gbThreepwood/headphone-amp/power-supply/img/enclosure_drawing.png

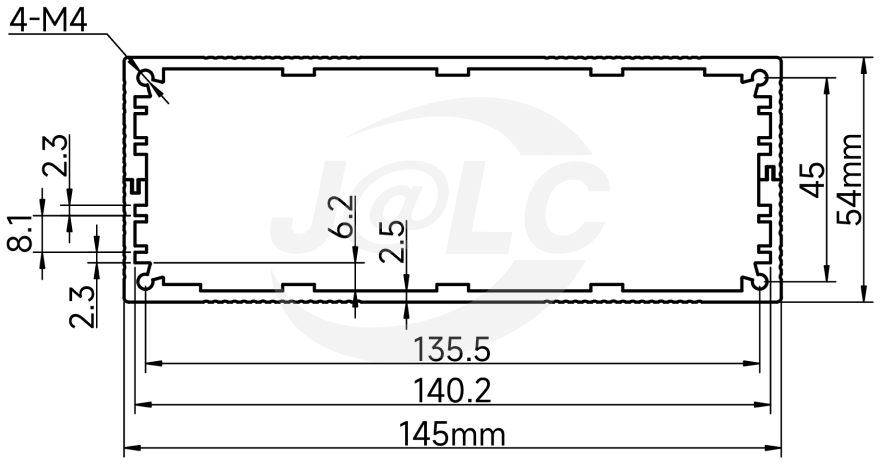
power-supply/img/enclosure_drawing.png
