gbThreepwood/headphone-amp/power-supply/3d_models/toroidal_transformer-Assembly.step

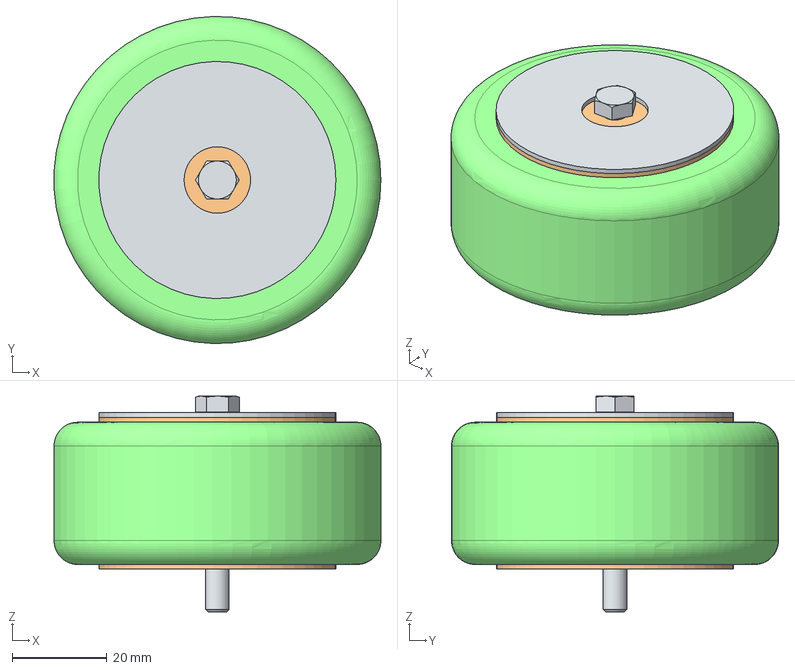
[picture p3: CAD file, 2025-01-01]
power-supply/3d_models/toroidal_transformer-Assembly.step
68.9 x 69.0 x 45.5 mm
Core001
Gasket x 2
Washer
M5x42-Screw
