gbThreepwood/headphone-amp/headphone-amp/3d_models/SJ-63073E.step

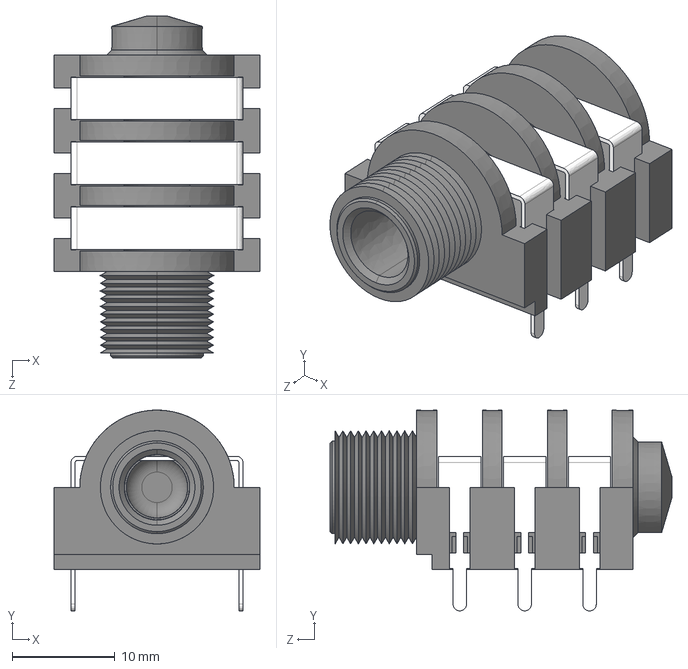
[picture p4: CAD file, 2025-01-01]
headphone-amp/3d_models/SJ-63073E.step
20.0 x 19.5 x 33.2 mm
