gbThreepwood/headphone-amp/enclosure/power-supply/aluminium_enclosure.FCStd

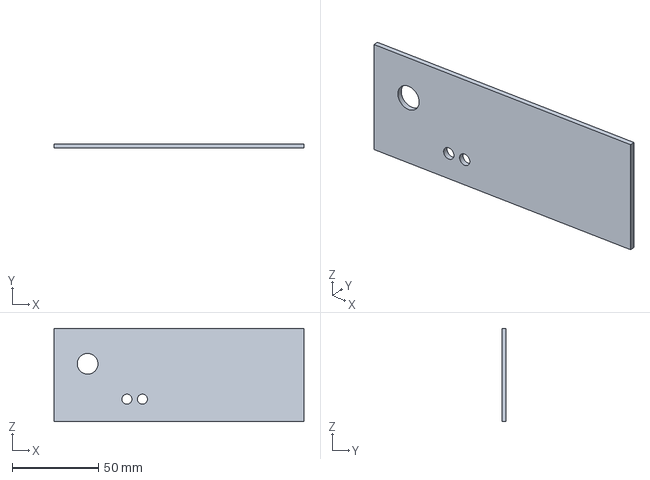
[picture p5: CAD file, 2024-12-26]
enclosure/power-supply/aluminium_enclosure.FCStd
145.0 x 2.50 x 54.0 mm
