gbThreepwood/headphone-amp/headphone-amp/3d_models/Same_Sky_RCJ-2211.step

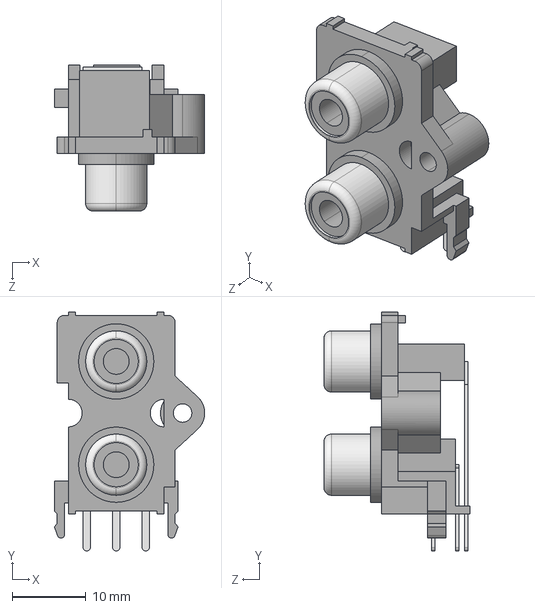
[picture p7: CAD file, 2025-01-01]
headphone-amp/3d_models/Same_Sky_RCJ-2211.step
20.4 x 32.4 x 19.8 mm
RCJ-22_RCJ-22XX
PLUG_Black x 2
