gbThreepwood/headphone-amp/headphone-amp/3d_models/PD-30.step

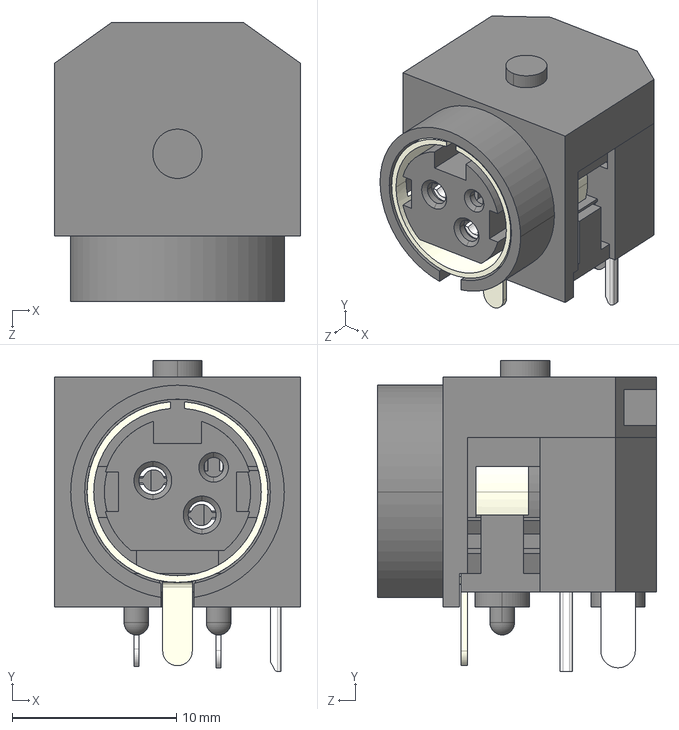
[picture p8: CAD file, 2025-01-01]
headphone-amp/3d_models/PD-30.step
15.0 x 18.9 x 17.0 mm
