gbThreepwood/headphone-amp/(list of files, cad)

Other CAD files:
enclosure/power-supply/pcb_enclosure_assembly.FCStd
