gbThreepwood/headphone-amp/headphone-amp/ltspice/toggle_circuit.asc

C1: cap; 470n
D1: diode; 1N4148
M1: nmos; BSP89
M2: pmos; BSS84
R1: res; 10k
R2: res; 100k
R3: res; 300
R4: res; 100k
S1: sw; MYSW
V1: voltage; 12
V2: voltage; PULSE(0 1 1 1n 1n 1 2)
Named nets: 0
.tran 7 startup
.model MYSW SW(Ron=1 Roff=1Meg Vt=.5 Vh=-.4)
