gbThreepwood/headphone-amp/power-supply/power-supply.kicad_pcb

## KiCad design power-supply/power-supply.kicad_pcb (2025-01-01)

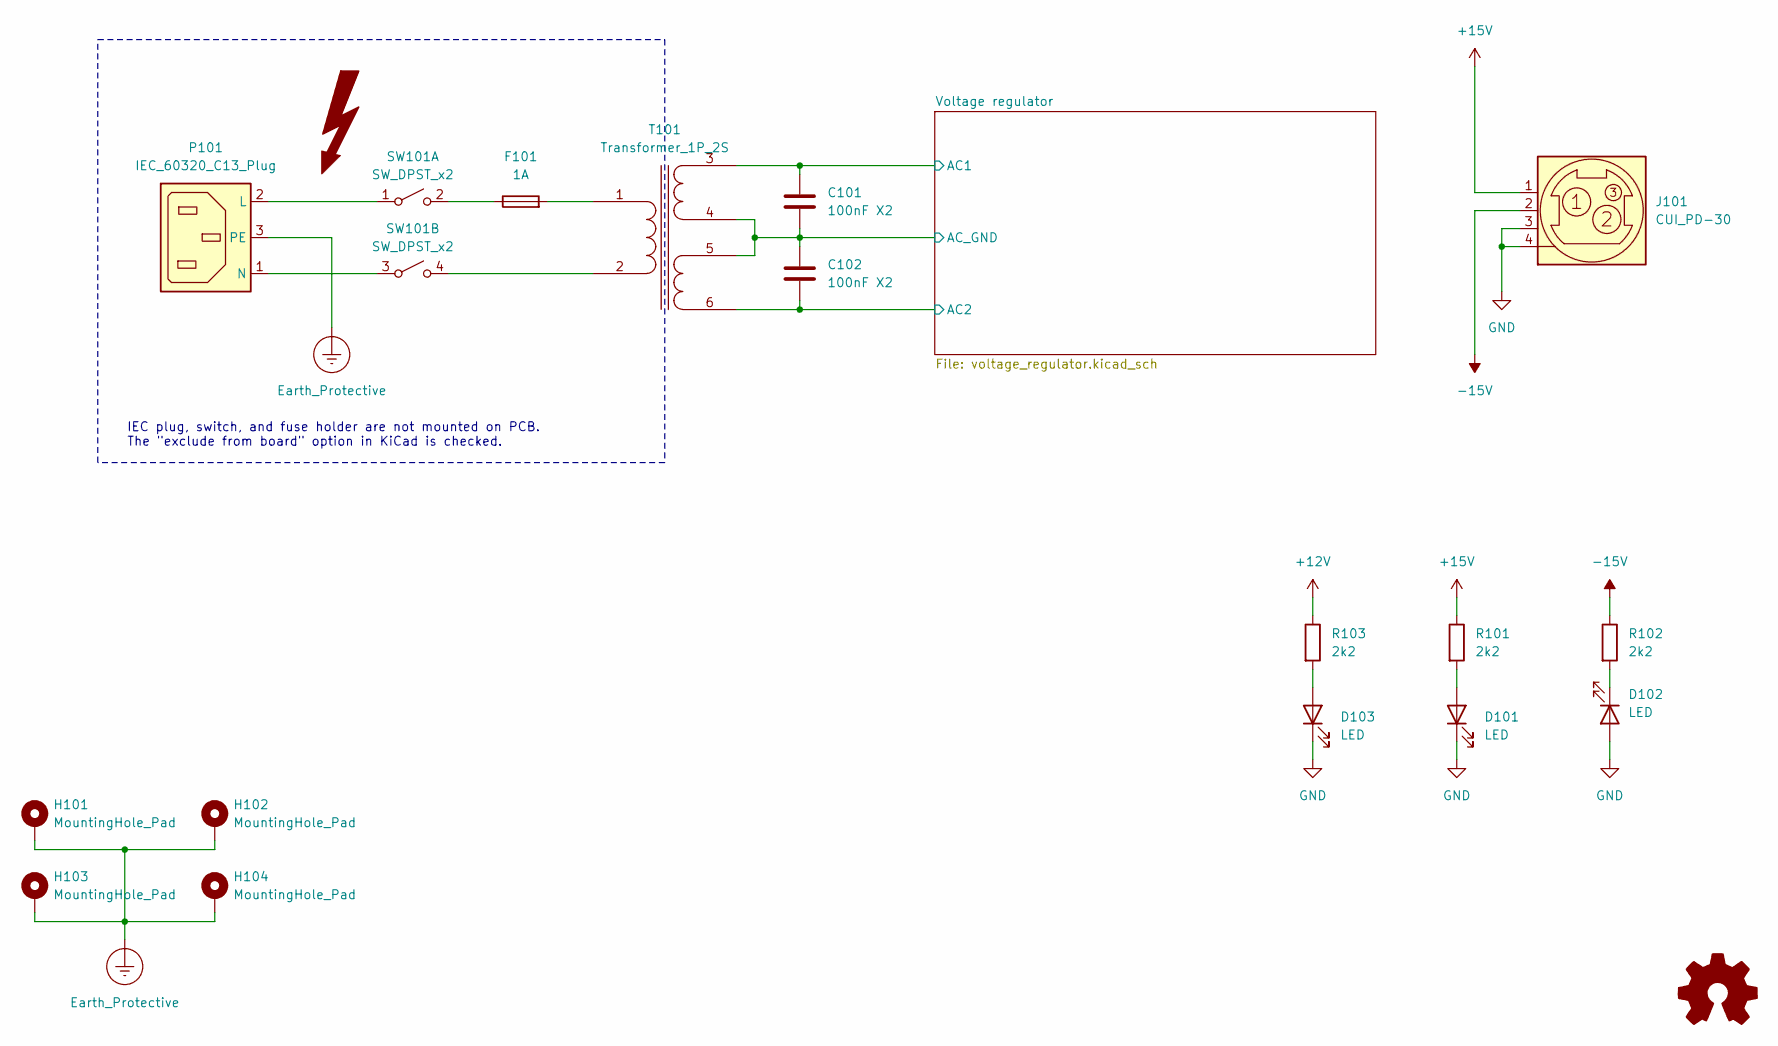
[picture p9: schematic power-supply.kicad_sch, Linear power supply]

Parts:
C101, C102: 100nF X2; C_Axial_L19.0mm_D7.5mm_P25.00mm_Horizontal
D101, D102, D103: LED; LED_D5.0mm_Horizontal_O3.81mm_Z3.0mm
F101: 1A
H101, H102, H103, H104: MountingHole_Pad; MountingHole_4mm_Pad_TopBottom
J101: CUI_PD-30
P101: IEC_60320_C13_Plug
R101, R102, R103: 2k2; R_Axial_DIN0207_L6.3mm_D2.5mm_P10.16mm_Horizontal
SW101: SW_DPST_x2
T101: Transformer_1P_2S; ToroidalTransformer 30VA

Connections:
+12V: R103.1; also elsewhere on the board
+15V: J101.1, R101.1; also elsewhere on the board
-15V: J101.2, R102.1; also elsewhere on the board
/Voltage regulator/AC1: C101.1, T101.3 (SA); also elsewhere on the board
/Voltage regulator/AC2: C102.2, T101.6 (SD); also elsewhere on the board
Earth_Protective: H101.1, H102.1, H103.1, H104.1, P101.3 (PE)
GND: C101.2, C102.1, D101.1 (K), D102.2 (A), D103.1 (K), J101.3, J101.4 (Shield), T101.4 (SB), T101.5 (SC); also elsewhere on the board
unnamed: D101.2 (A), R101.2
unnamed: D102.1 (K), R102.2
unnamed: D103.2 (A), R103.2
unnamed: F101.1, SW101.2 (B)
unnamed: P101.1 (N), SW101.3 (A)
unnamed: P101.2 (L), SW101.1 (A)
unnamed: F101.2, T101.1 (AA)
unnamed: SW101.4 (B), T101.2 (AB)

Notes on the sheet:
IEC plug, switch, and fuse holder are not mounted on PCB. The "exclude from board" option in KiCad is checked.

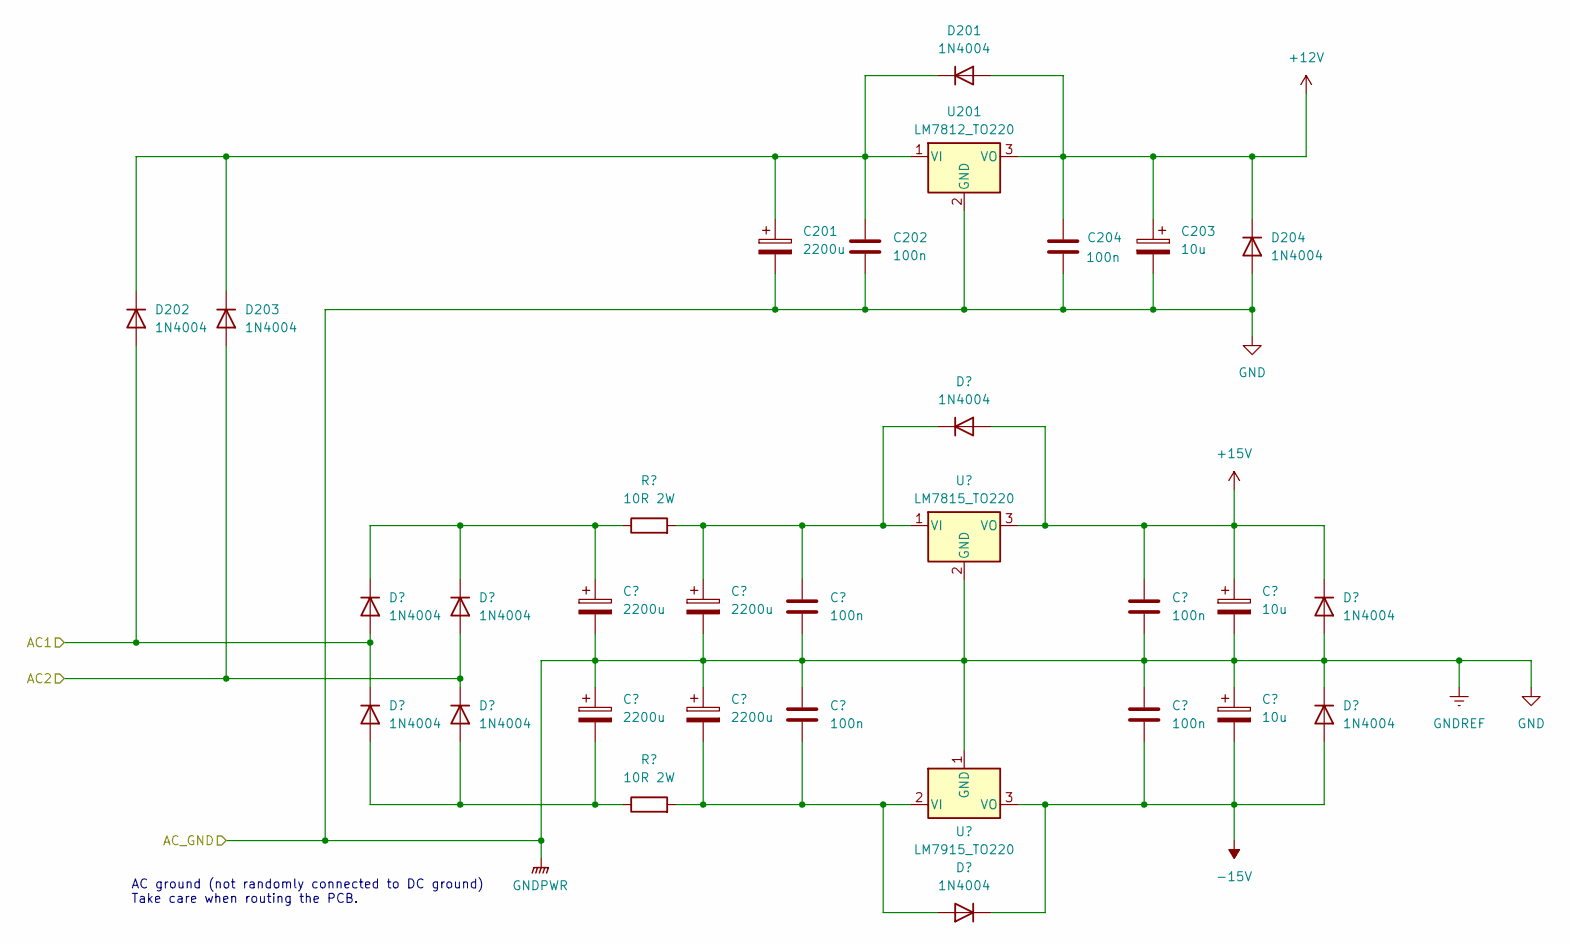
[picture p10: schematic voltage_regulator.kicad_sch, Dual voltage power supply]

Parts:
C201, C401, C402, C403, C404: 2200u; CP_Radial_D18.0mm_P7.50mm
C202, C204, C405, C406, C407, C408: 100n; C_Disc_D6.0mm_W2.5mm_P5.00mm
C203, C409, C410: 10u; CP_Radial_D5.0mm_P2.00mm
D201, D202, D203, D204, D401, D402, D403, D404, D405, D406, D408, D409: 1N4004; D_DO-41_SOD81_P10.16mm_Horizontal
R401, R402: 10R 2W; R_Axial_DIN0309_L9.0mm_D3.2mm_P12.70mm_Horizontal
U201: LM7812_TO220; TO-220-3_Vertical
U401: LM7815_TO220; TO-220-3_Vertical
U402: LM7915_TO220; TO-220-3_Vertical

Connections:
+12V: C203.1, C204.1, D201.2 (A), D204.1 (K), U201.3 (VO); also elsewhere on the board
+15V: C407.1, C409.1, D405.2 (A), D408.1 (K), U401.3 (VO); also elsewhere on the board
-15V: C408.2, C410.2, D406.1 (K), D409.2 (A), U402.3 (VO); also elsewhere on the board
/Voltage regulator/AC1: D202.2 (A), D401.2 (A), D402.1 (K); also elsewhere on the board
/Voltage regulator/AC2: D203.2 (A), D403.2 (A), D404.1 (K); also elsewhere on the board
GND: C201.2, C202.2, C203.2, C204.2, C401.2, C402.1, C403.2, C404.1, C405.2, C406.1, C407.2, C408.1, C409.2, C410.1, D204.2 (A), D408.2 (A), D409.1 (K), U201.2 (GND), U401.2 (GND), U402.1 (GND); also elsewhere on the board
unnamed: C201.1, C202.1, D201.1 (K), D202.1 (K), D203.1 (K), U201.1 (VI)
unnamed: C401.1, D401.1 (K), D403.1 (K), R401.1
unnamed: C402.2, D402.2 (A), D404.2 (A), R402.1
unnamed: C403.1, C405.1, D405.1 (K), R401.2, U401.1 (VI)
unnamed: C404.2, C406.2, D406.2 (A), R402.2, U402.2 (VI)

Notes on the sheet:
AC ground (not randomly connected to DC ground) Take care when routing the PCB.

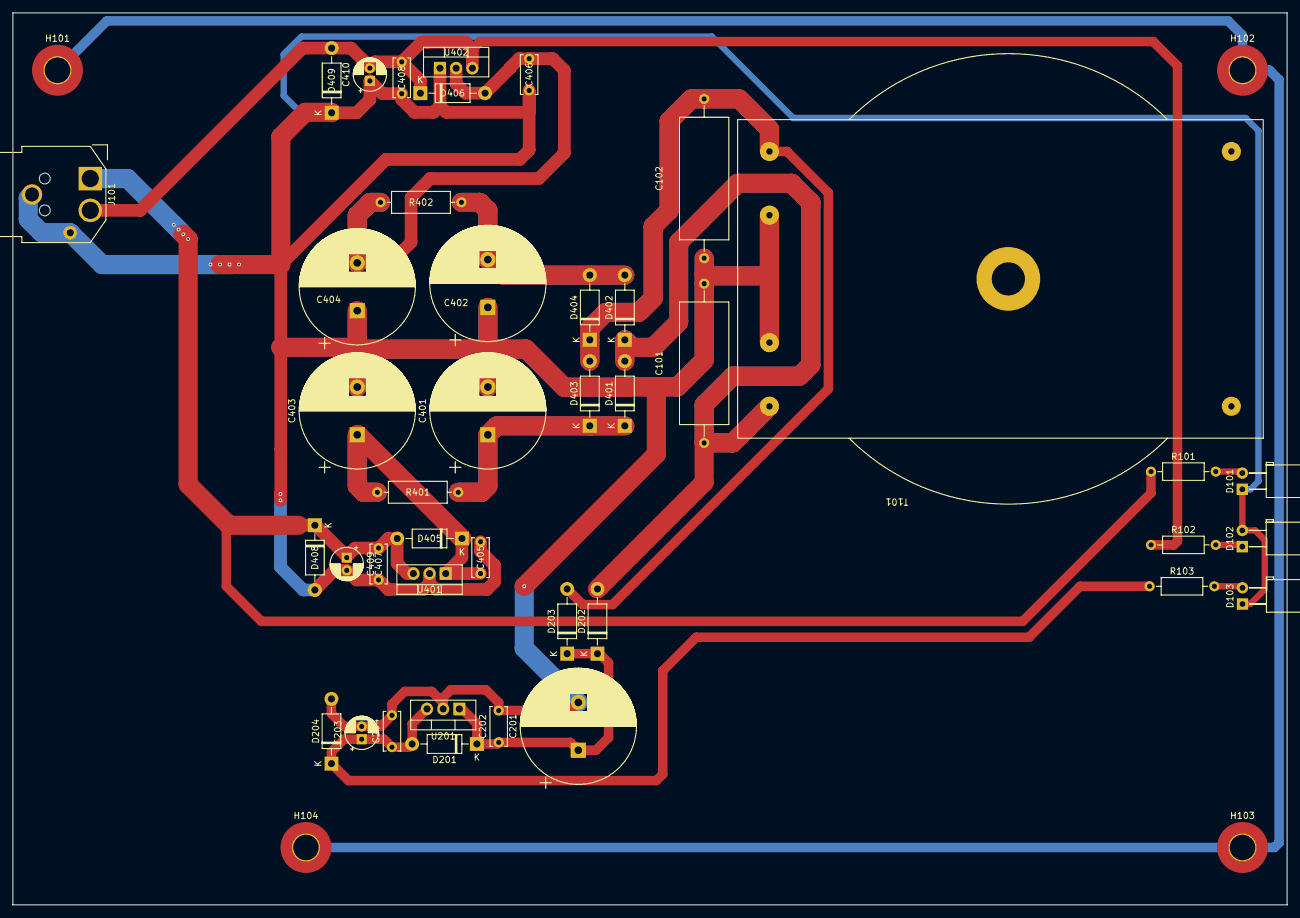
[picture p11: board power-supply.kicad_pcb from above]

Board: 2 copper layers, 200.0 x 140.0 mm, 45 parts (0 on the bottom side), 15 nets.
