gbThreepwood/headphone-amp/headphone-amp/headphone-amp.kicad_pcb

## KiCad design headphone-amp/headphone-amp.kicad_pcb (2025-01-01)

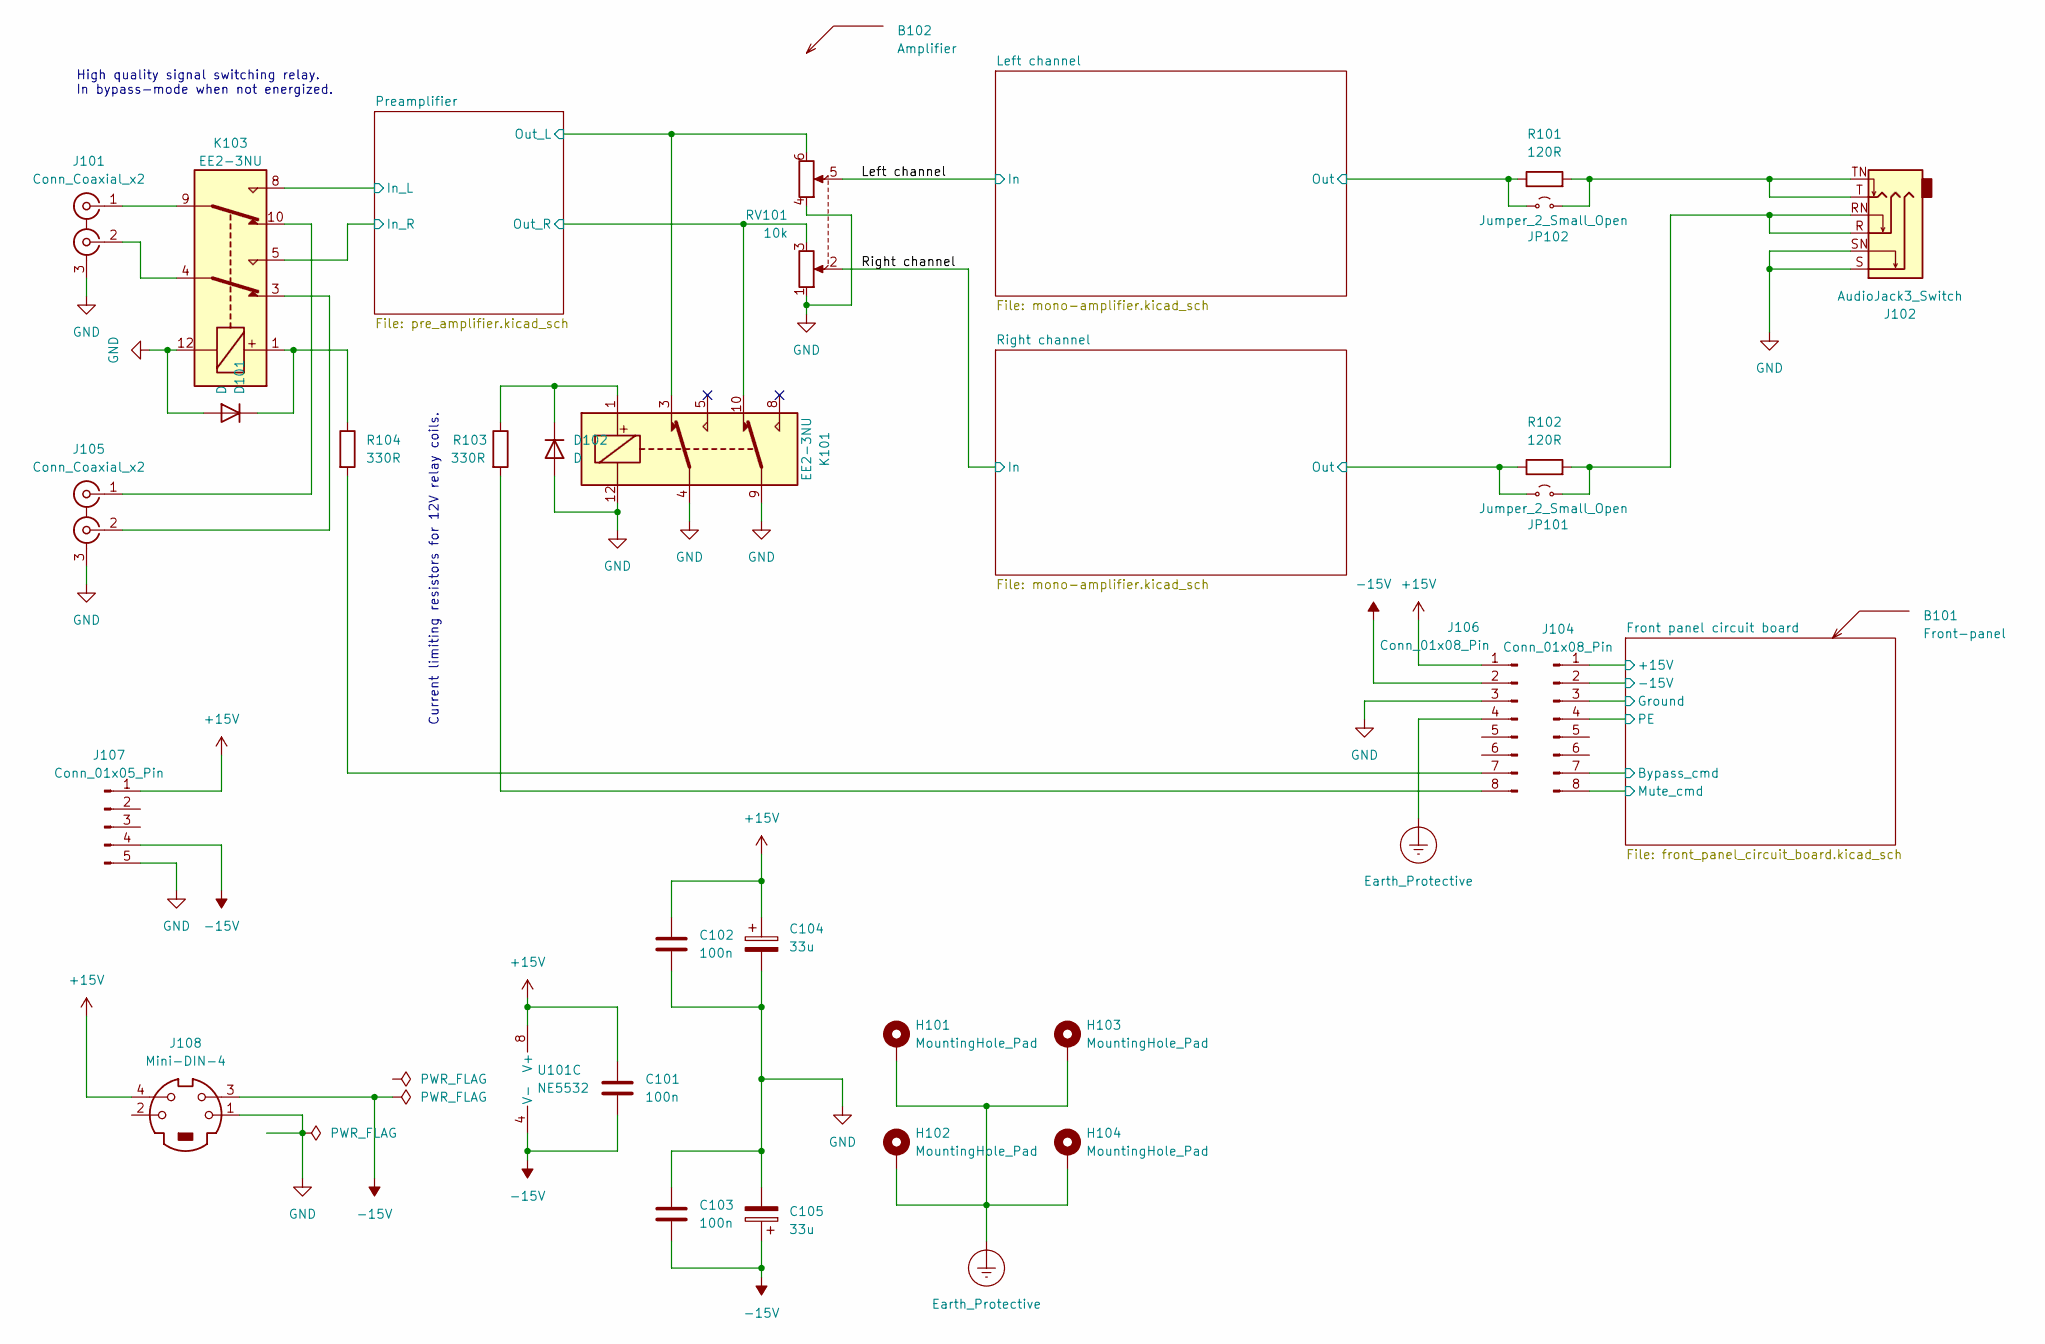
[picture p12: schematic headphone-amp.kicad_sch, HiFi headphone amplifier]

Parts:
B101: Front-panel; Board
B102: Amplifier; Board
C101, C102, C103: 100n; C_Disc_D6.0mm_W2.5mm_P5.00mm
C104, C105: 33u; CP_Radial_D6.3mm_P2.50mm
D101, D102: D; D_DO-35_SOD27_P7.62mm_Horizontal
H101, H102, H103, H104: MountingHole_Pad; MountingHole_4.3mm_M4_DIN965_Pad_TopBottom
J101, J105: Conn_Coaxial_x2; rcj-22 vertical RCA
J102: AudioJack3_Switch; CUI_SJ-63073E
J104, J106: Conn_01x08_Pin; PinHeader_1x08_P2.54mm_Vertical
J107: Conn_01x05_Pin; PhoenixContact_GMSTB_2,5_5-GF-7,62_1x05_P7.62mm_Horizontal_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
J108: Mini-DIN-4
JP101, JP102: Jumper_2_Small_Open; PinHeader_2x01_P2.54mm_Vertical
K101, K103: EE2-3NU; Relay_DPDT_Kemet_EE2_NU
R101, R102: 120R; R_Axial_DIN0207_L6.3mm_D2.5mm_P10.16mm_Horizontal
R103, R104: 330R; R_Axial_DIN0207_L6.3mm_D2.5mm_P10.16mm_Horizontal
RV101: 10k; Potentiometer_Alps_RK163_Dual_Horizontal
U101: NE5532; DIP-8_W7.62mm_LongPads

Connections:
+15V: C101.1, C102.1, C104.1, J106.1, J107.1, J108.4, U101.8 (V+); also elsewhere on the board
-15V: C101.2, C103.1, C105.1, J106.2, J107.4, J108.3, U101.4 (V-); also elsewhere on the board
/Front panel circuit board/+15V: J104.1; also elsewhere on the board
/Front panel circuit board/-15V: J104.2
/Front panel circuit board/Bypass_cmd: J104.7; also elsewhere on the board
/Front panel circuit board/Ground: J104.3; also elsewhere on the board
/Front panel circuit board/Mute_cmd: J104.8; also elsewhere on the board
/Front panel circuit board/PE: J104.4; also elsewhere on the board
/Left channel: RV101.5; also elsewhere on the board
/Left channel/Out: JP102.1 (A), R101.1; also elsewhere on the board
/Preamplifier/In_L: K103.8; also elsewhere on the board
/Preamplifier/In_R: K103.5; also elsewhere on the board
/Preamplifier/Out_L: K101.3, RV101.6; also elsewhere on the board
/Preamplifier/Out_R: K101.10, RV101.3; also elsewhere on the board
/Right channel: RV101.2; also elsewhere on the board
/Right channel/Out: JP101.1 (A), R102.1; also elsewhere on the board
Earth_Protective: H101.1, H102.1, H103.1, H104.1, J106.4
GND: C102.2, C103.2, C104.2, C105.2, D101.2 (A), D102.2 (A), J101.3 (EXT), J102.S, J102.SN, J105.3 (EXT), J106.3, J107.5, J108.1, K101.4, K101.9, K101.12, K103.12, RV101.1, RV101.4; also elsewhere on the board
unnamed: D101.1 (K), K103.1, R104.1
unnamed: D102.1 (K), K101.1, R103.1
unnamed 31: U101.1; also elsewhere on the board
unnamed: J101.1 (IN1), K103.9
unnamed: J101.2 (IN2), K103.4
unnamed: J105.1 (IN1), K103.10
unnamed: J105.2 (IN2), K103.3
unnamed: J106.7, R104.2
unnamed: J106.8, R103.2
unnamed: J102.R, J102.RN, JP101.2 (B), R102.2
unnamed: J102.T, J102.TN, JP102.2 (B), R101.2
unnamed 55: U101.3 (+); also elsewhere on the board
unnamed 56: U101.2 (-); also elsewhere on the board

Notes on the sheet:
Current limiting resistors for 12V relay coils.
High quality signal switching relay. In bypass-mode when not energized.

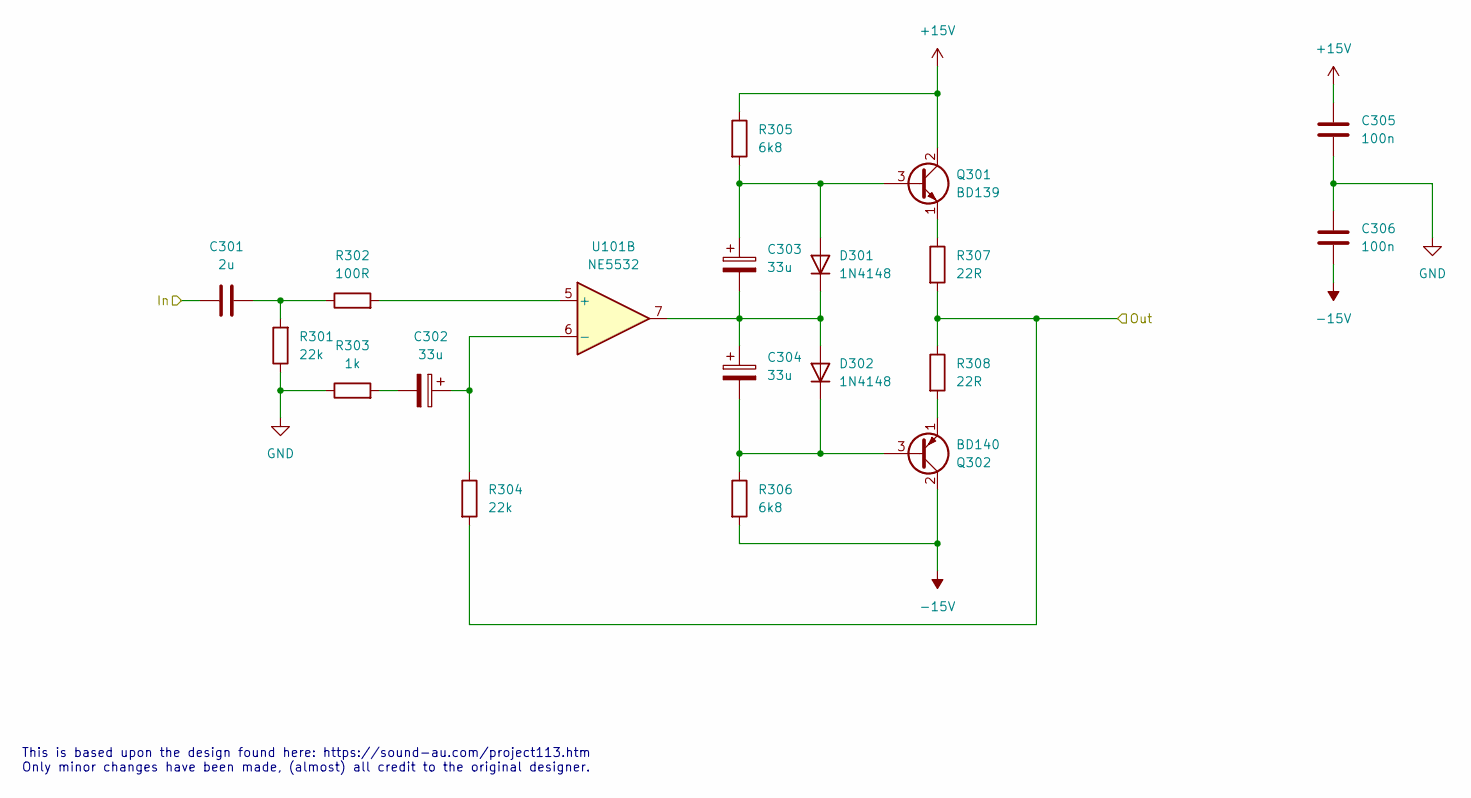
[picture p13: schematic mono-amplifier.kicad_sch, One channel of headphone amplifier]

Parts:
C301: 2u; C_Axial_L12.0mm_D7.5mm_P15.00mm_Horizontal
C302, C303, C304: 33u; CP_Radial_D6.3mm_P2.50mm
C305, C306: 100n; C_Disc_D6.0mm_W2.5mm_P5.00mm
D301, D302: 1N4148; D_DO-35_SOD27_P7.62mm_Horizontal
Q301: BD139; TO-126-3_Vertical
Q302: BD140; TO-126-3_Vertical
R301, R304: 22k; R_Axial_DIN0207_L6.3mm_D2.5mm_P10.16mm_Horizontal
R302: 100R; R_Axial_DIN0207_L6.3mm_D2.5mm_P10.16mm_Horizontal
R303: 1k; R_Axial_DIN0207_L6.3mm_D2.5mm_P10.16mm_Horizontal
R305, R306: 6k8; R_Axial_DIN0207_L6.3mm_D2.5mm_P10.16mm_Horizontal
R307, R308: 22R; R_Axial_DIN0207_L6.3mm_D2.5mm_P10.16mm_Horizontal
U101: NE5532; DIP-8_W7.62mm_LongPads

Connections:
+15V: C305.2, Q301.2 (C), R305.1; also elsewhere on the board
-15V: C306.1, Q302.2 (C), R306.2; also elsewhere on the board
/Right channel: C301.1; also elsewhere on the board
/Right channel/Out: R304.2, R307.2, R308.1; also elsewhere on the board
GND: C305.1, C306.2, R301.1, R303.1; also elsewhere on the board
unnamed: C301.2, R301.2, R302.1
unnamed: C302.2, R303.2
unnamed 31: U101.1; also elsewhere on the board
unnamed: C303.1, D301.2 (A), Q301.3 (B), R305.2
unnamed: C303.2, C304.1, D301.1 (K), D302.2 (A), U101.7
unnamed: C304.2, D302.1 (K), Q302.3 (B), R306.1
unnamed: Q301.1 (E), R307.1
unnamed: Q302.1 (E), R308.2
unnamed 55: U101.3 (+); also elsewhere on the board
unnamed 56: U101.2 (-); also elsewhere on the board
unnamed: R302.2, U101.5 (+)
unnamed: C302.1, R304.1, U101.6 (-)

Parts of its further copies:
C201: 2u; C_Axial_L12.0mm_D7.5mm_P15.00mm_Horizontal
C202, C203, C204: 33u; CP_Radial_D6.3mm_P2.50mm
C205, C206: 100n; C_Disc_D6.0mm_W2.5mm_P5.00mm
D201, D202: 1N4148; D_DO-35_SOD27_P7.62mm_Horizontal
Q201: BD139; TO-126-3_Vertical
Q202: BD140; TO-126-3_Vertical
R201, R204: 22k; R_Axial_DIN0207_L6.3mm_D2.5mm_P10.16mm_Horizontal
R202: 100R; R_Axial_DIN0207_L6.3mm_D2.5mm_P10.16mm_Horizontal
R203: 1k; R_Axial_DIN0207_L6.3mm_D2.5mm_P10.16mm_Horizontal
R205, R206: 6k8; R_Axial_DIN0207_L6.3mm_D2.5mm_P10.16mm_Horizontal
R207, R208: 22R; R_Axial_DIN0207_L6.3mm_D2.5mm_P10.16mm_Horizontal

Connections of its further copies:
+15V: C205.2, Q201.2 (C), R205.1; also elsewhere on the board
-15V: C206.1, Q202.2 (C), R206.2; also elsewhere on the board
/Left channel: C201.1; also elsewhere on the board
/Left channel/Out: R204.2, R207.2, R208.1; also elsewhere on the board
GND: C205.1, C206.2, R201.1, R203.1; also elsewhere on the board
unnamed: C201.2, R201.2, R202.1
unnamed: C202.2, R203.2
unnamed: C203.1, D201.2 (A), Q201.3 (B), R205.2
unnamed 31: C203.2, C204.1, D201.1 (K), D202.2 (A); also elsewhere on the board
unnamed: C204.2, D202.1 (K), Q202.3 (B), R206.1
unnamed: Q201.1 (E), R207.1
unnamed: Q202.1 (E), R208.2
unnamed 55: R202.2; also elsewhere on the board
unnamed 56: C202.1, R204.1; also elsewhere on the board

Notes on the sheet:
This is based upon the design found here: https://sound-au.com/project113.htm Only minor changes have been made, (almost) all credit to the original designer.

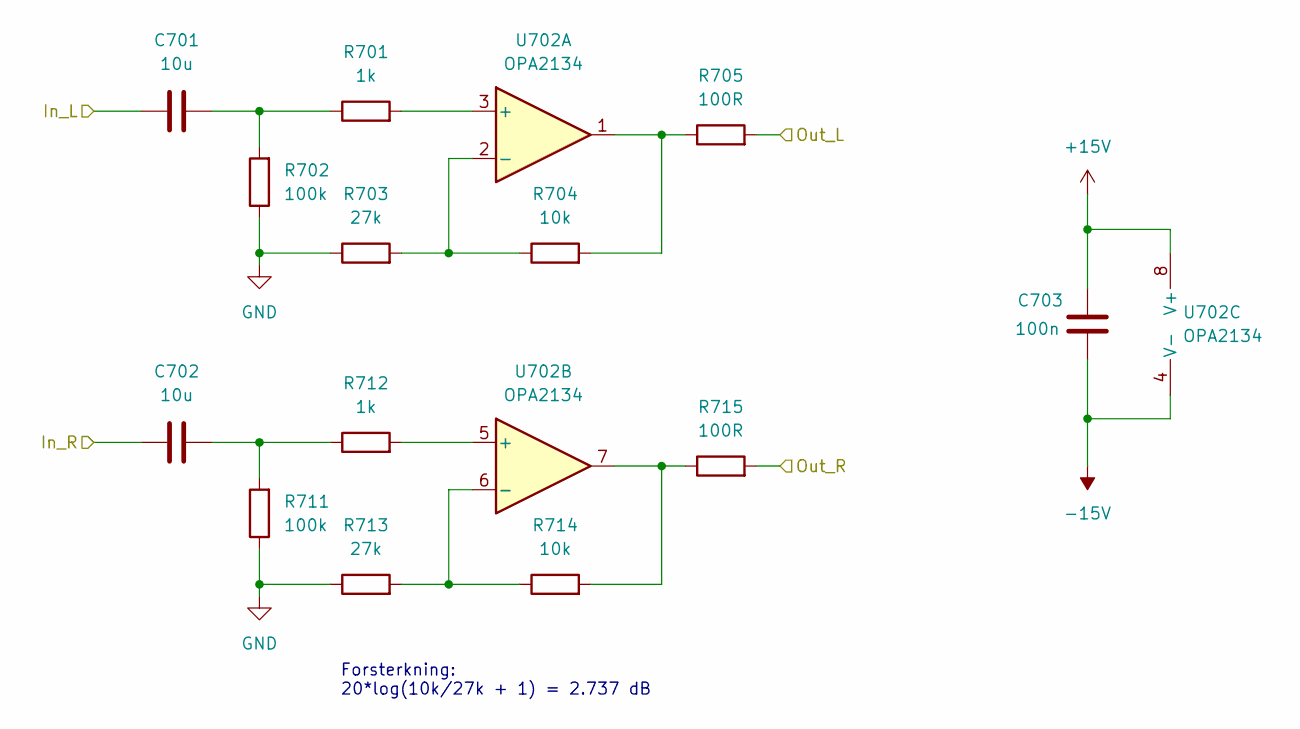
[picture p14: schematic pre_amplifier.kicad_sch]

Parts:
C701, C702: 10u; C_Axial_L12.0mm_D7.5mm_P15.00mm_Horizontal
C703: 100n; C_Disc_D6.0mm_W2.5mm_P5.00mm
R701, R712: 1k; R_Axial_DIN0207_L6.3mm_D2.5mm_P10.16mm_Horizontal
R702, R711: 100k; R_Axial_DIN0207_L6.3mm_D2.5mm_P10.16mm_Horizontal
R703, R713: 27k; R_Axial_DIN0207_L6.3mm_D2.5mm_P10.16mm_Horizontal
R704, R714: 10k; R_Axial_DIN0207_L6.3mm_D2.5mm_P10.16mm_Horizontal
R705, R715: 100R; R_Axial_DIN0207_L6.3mm_D2.5mm_P10.16mm_Horizontal
U702: OPA2134; DIP-8_W7.62mm_LongPads

Connections:
+15V: C703.1, U702.8 (V+); also elsewhere on the board
-15V: C703.2, U702.4 (V-); also elsewhere on the board
/Preamplifier/In_L: C701.1; also elsewhere on the board
/Preamplifier/In_R: C702.1; also elsewhere on the board
/Preamplifier/Out_L: R705.2; also elsewhere on the board
/Preamplifier/Out_R: R715.2; also elsewhere on the board
GND: R702.1, R703.1, R711.1, R713.1; also elsewhere on the board
unnamed: C701.2, R701.1, R702.2
unnamed: C702.2, R711.2, R712.1
unnamed: R704.2, R705.1, U702.1
unnamed: R714.2, R715.1, U702.7
unnamed: R701.2, U702.3 (+)
unnamed: R703.2, R704.1, U702.2 (-)
unnamed: R712.2, U702.5 (+)
unnamed: R713.2, R714.1, U702.6 (-)

Notes on the sheet:
Forsterkning: 20*log(10k/27k + 1) = 2.737 dB

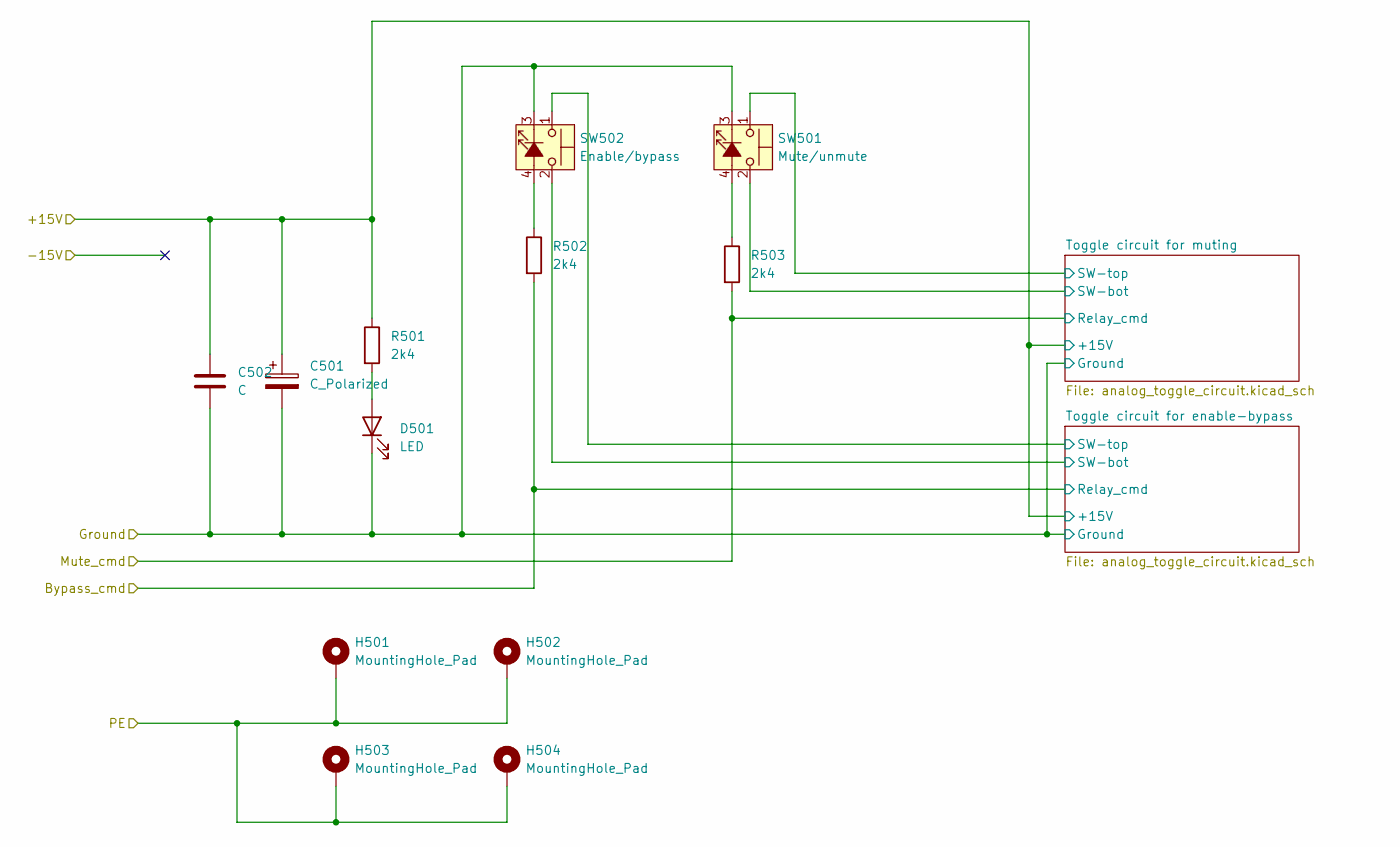
[picture p15: schematic front_panel_circuit_board.kicad_sch]

Parts:
C501: C_Polarized; CP_Elec_6.3x5.8
C502: C; C_1206_3216Metric_Pad1.33x1.80mm_HandSolder
D501: LED; LED_1812_4532Metric
H501, H502, H503, H504: MountingHole_Pad; MountingHole_4.3mm_M4_DIN965_Pad_TopBottom
R501, R502, R503: 2k4; R_1206_3216Metric_Pad1.30x1.75mm_HandSolder
SW501: Mute/unmute; SW_Push_2P1T_Toggle_CK_PVA1xxH1xxxxxxV2
SW502: Enable/bypass; SW_Push_2P1T_Toggle_CK_PVA1xxH1xxxxxxV2

Connections:
/Front panel circuit board/+15V: C501.1, C502.1, R501.1; also elsewhere on the board
/Front panel circuit board/Bypass_cmd: R502.2; also elsewhere on the board
/Front panel circuit board/Ground: C501.2, C502.2, D501.1 (K), SW501.3 (K), SW502.3 (K); also elsewhere on the board
/Front panel circuit board/Mute_cmd: R503.2; also elsewhere on the board
/Front panel circuit board/PE: H501.1, H502.1, H503.1, H504.1; also elsewhere on the board
/Front panel circuit board/Toggle circuit for enable-bypass/SW-bot: SW502.2; also elsewhere on the board
/Front panel circuit board/Toggle circuit for enable-bypass/SW-top: SW502.1; also elsewhere on the board
/Front panel circuit board/Toggle circuit for muting/SW-bot: SW501.2; also elsewhere on the board
/Front panel circuit board/Toggle circuit for muting/SW-top: SW501.1; also elsewhere on the board
unnamed: D501.2 (A), R501.2
unnamed: R503.1, SW501.4 (A)
unnamed: R502.1, SW502.4 (A)

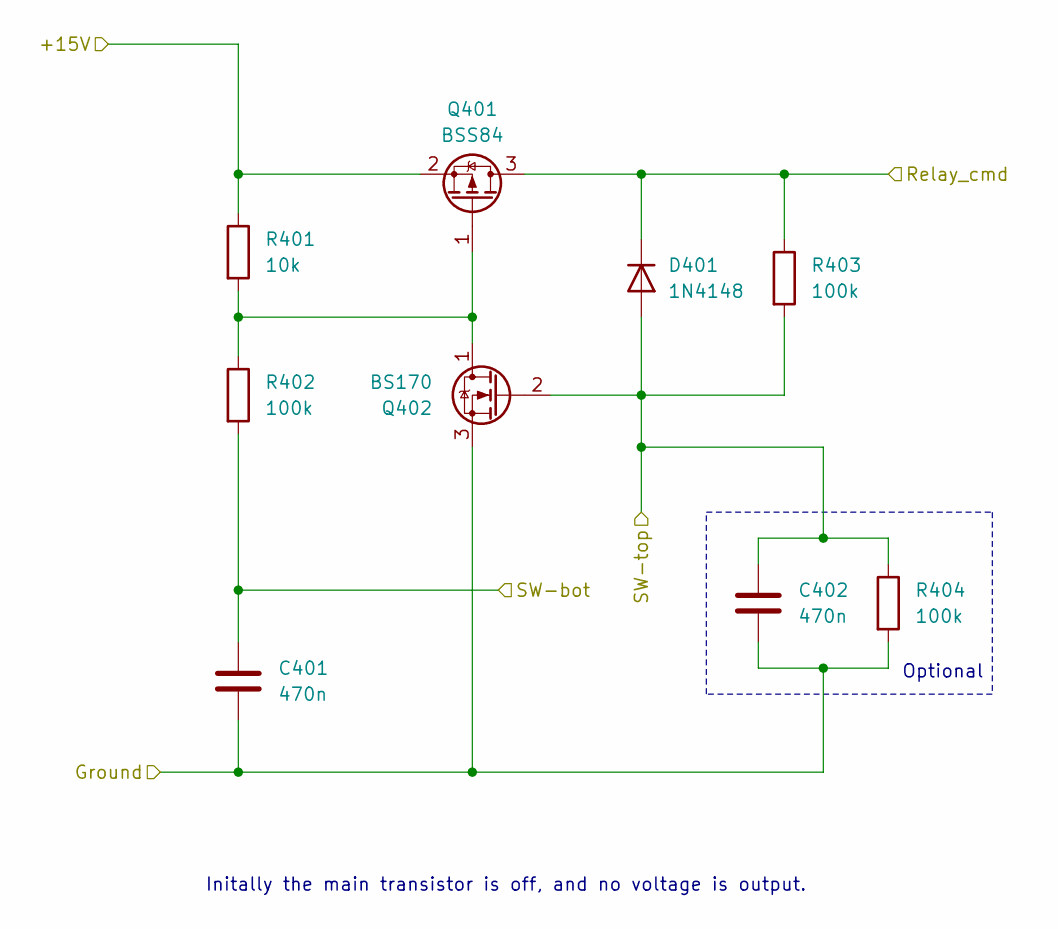
[picture p16: schematic analog_toggle_circuit.kicad_sch, Impluse switch toggle circuit]

Parts:
C401, C402: 470n; C_1206_3216Metric_Pad1.33x1.80mm_HandSolder
D401: 1N4148; D_SOD-123
Q401: BSS84; SOT-23
Q402: BS170; SOT-23
R401: 10k; R_1206_3216Metric_Pad1.30x1.75mm_HandSolder
R402, R403, R404: 100k; R_1206_3216Metric_Pad1.30x1.75mm_HandSolder

Connections:
/Front panel circuit board/+15V: Q401.2 (S), R401.1; also elsewhere on the board
/Front panel circuit board/Ground: C401.2, C402.2, Q402.3 (S), R404.2; also elsewhere on the board
/Front panel circuit board/Mute_cmd: D401.1 (K), Q401.3 (D), R403.1; also elsewhere on the board
/Front panel circuit board/Toggle circuit for muting/SW-bot: C401.1, R402.2; also elsewhere on the board
/Front panel circuit board/Toggle circuit for muting/SW-top: C402.1, D401.2 (A), Q402.2 (G), R403.2, R404.1; also elsewhere on the board
unnamed: Q401.1 (G), Q402.1 (D), R401.2, R402.1

Parts of its further copies:
C601, C602: 470n; C_1206_3216Metric_Pad1.33x1.80mm_HandSolder
D601: 1N4148; D_SOD-123
Q601: BSS84; SOT-23
Q602: BS170; SOT-23
R601: 10k; R_1206_3216Metric_Pad1.30x1.75mm_HandSolder
R602, R603, R604: 100k; R_1206_3216Metric_Pad1.30x1.75mm_HandSolder

Connections of its further copies:
/Front panel circuit board/+15V: Q601.2 (S), R601.1; also elsewhere on the board
/Front panel circuit board/Bypass_cmd: D601.1 (K), Q601.3 (D), R603.1; also elsewhere on the board
/Front panel circuit board/Ground: C601.2, C602.2, Q602.3 (S), R604.2; also elsewhere on the board
/Front panel circuit board/Toggle circuit for enable-bypass/SW-bot: C601.1, R602.2; also elsewhere on the board
/Front panel circuit board/Toggle circuit for enable-bypass/SW-top: C602.1, D601.2 (A), Q602.2 (G), R603.2, R604.1; also elsewhere on the board
unnamed: Q601.1 (G), Q602.1 (D), R601.2, R602.1

Notes on the sheet:
Initally the main transistor is off, and no voltage is output.
Optional

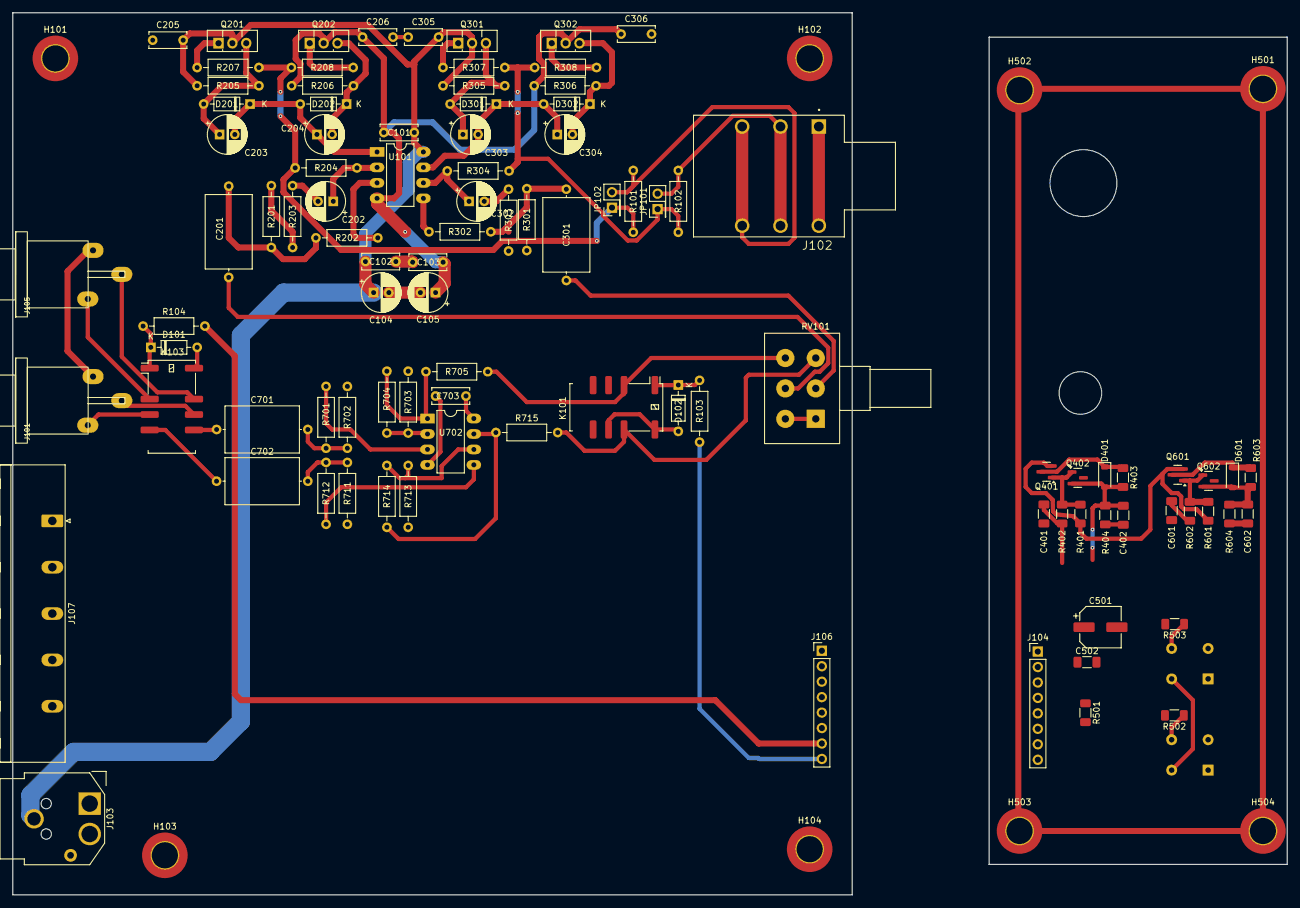
[picture p17: board headphone-amp.kicad_pcb from above]

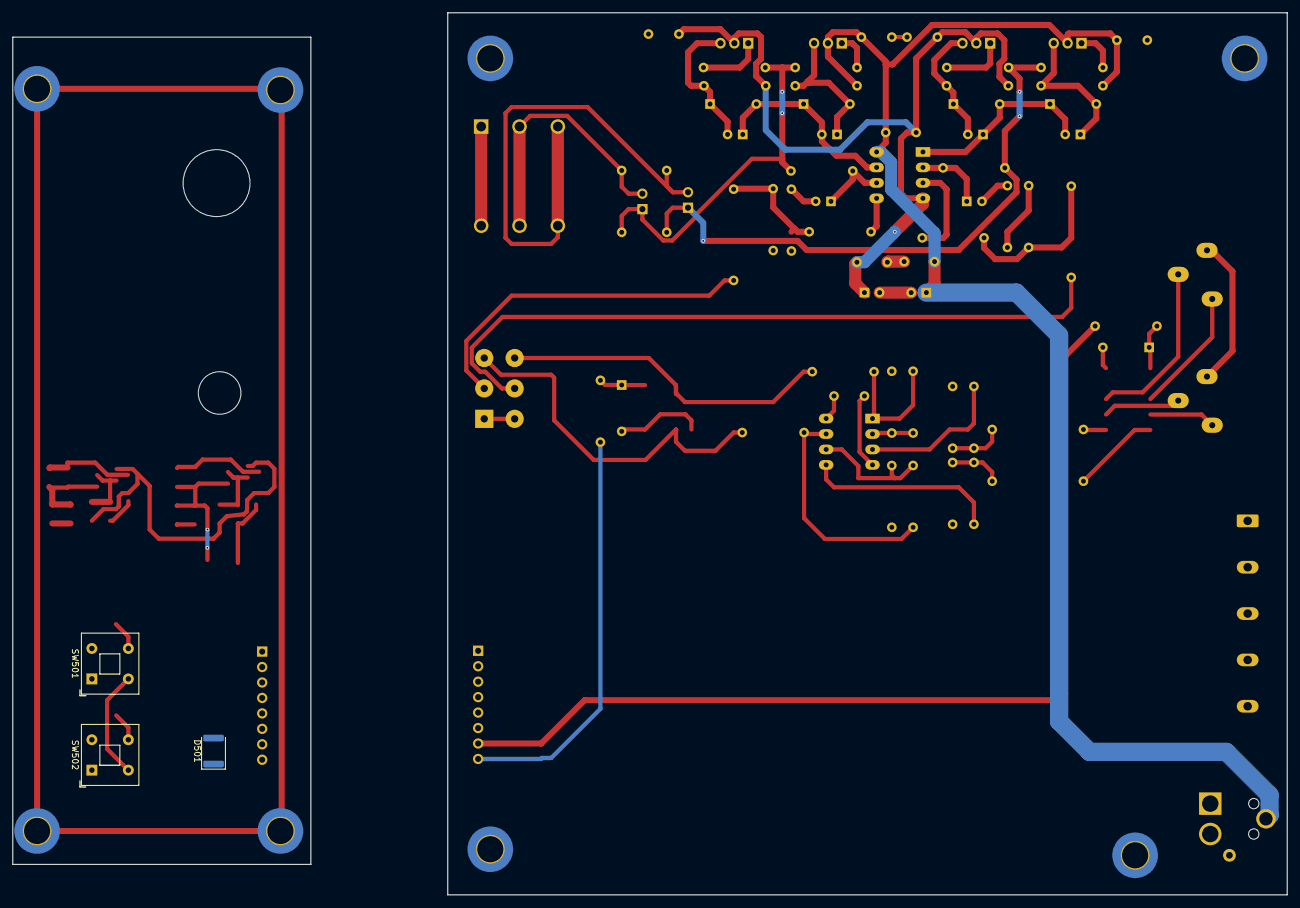
[picture p18: board headphone-amp.kicad_pcb from below]

Board: 2 copper layers, 209.5 x 145.0 mm, 110 parts (3 on the bottom side), 62 nets.

Other parts of the board:
J103: CUI_PD-30

Their connections:
+15V: J103.4 (Shield); also elsewhere on the board
-15V: J103.3; also elsewhere on the board
GND: J103.1, J103.2; also elsewhere on the board
