gbThreepwood/headphone-amp/(commit log)

2024-12-26 Added 3d-model of power supply enclosure
    [aluminium_enclosure.FCStd, pcb_enclosure_assembly.FCStd]
2025-01-01 Added simulation of toggle switch circuit
2025-01-01 Updated headphone-amp kicad project
    [LED_D5.0mm_Horizontal_O3.81mm_Z3.0mm.step, PD-30.step, SJ-63073E.step, Same_Sky_RCJ-2211.step, Same_Sky_SJ-63073E.step, analog_toggle_circuit.kicad_sch, front_panel_circuit_board.kicad_sch, headphone-amp.kicad_pcb]
2025-01-01 Some additions to power supply
    [power-supply.kicad_pcb, power-supply.kicad_sch, toroidal_transformer-Assembly.step, voltage_regulator.kicad_sch]
